shanmukhram/OrangeV2-2.0/media/Orange_Sesame_Walk.gif

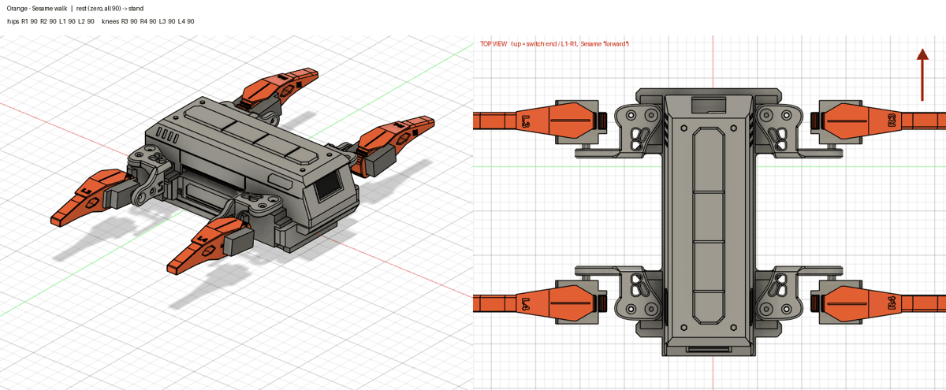
media/Orange_Sesame_Walk.gif
