shanmukhram/OrangeV2-2.0/media/Orange_Walk_Smooth_front.gif

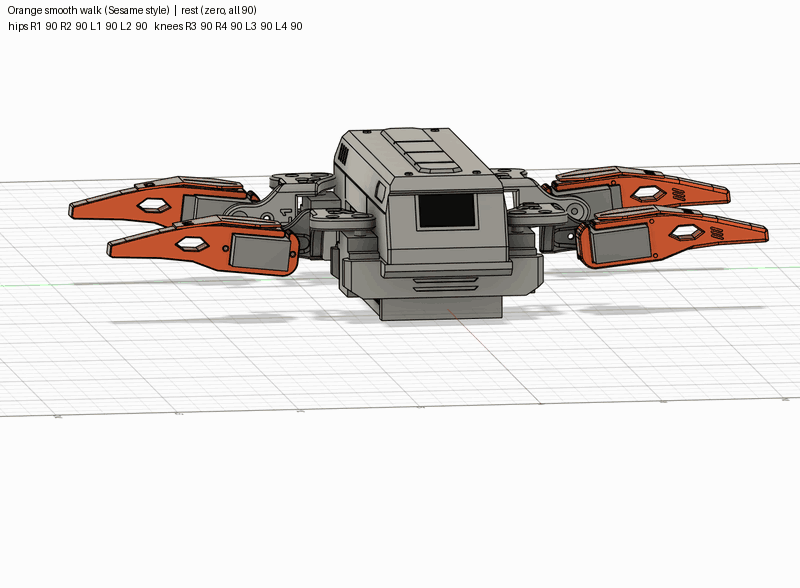
media/Orange_Walk_Smooth_front.gif
