shanmukhram/OrangeV2-2.0/media/skirt_design_options.png

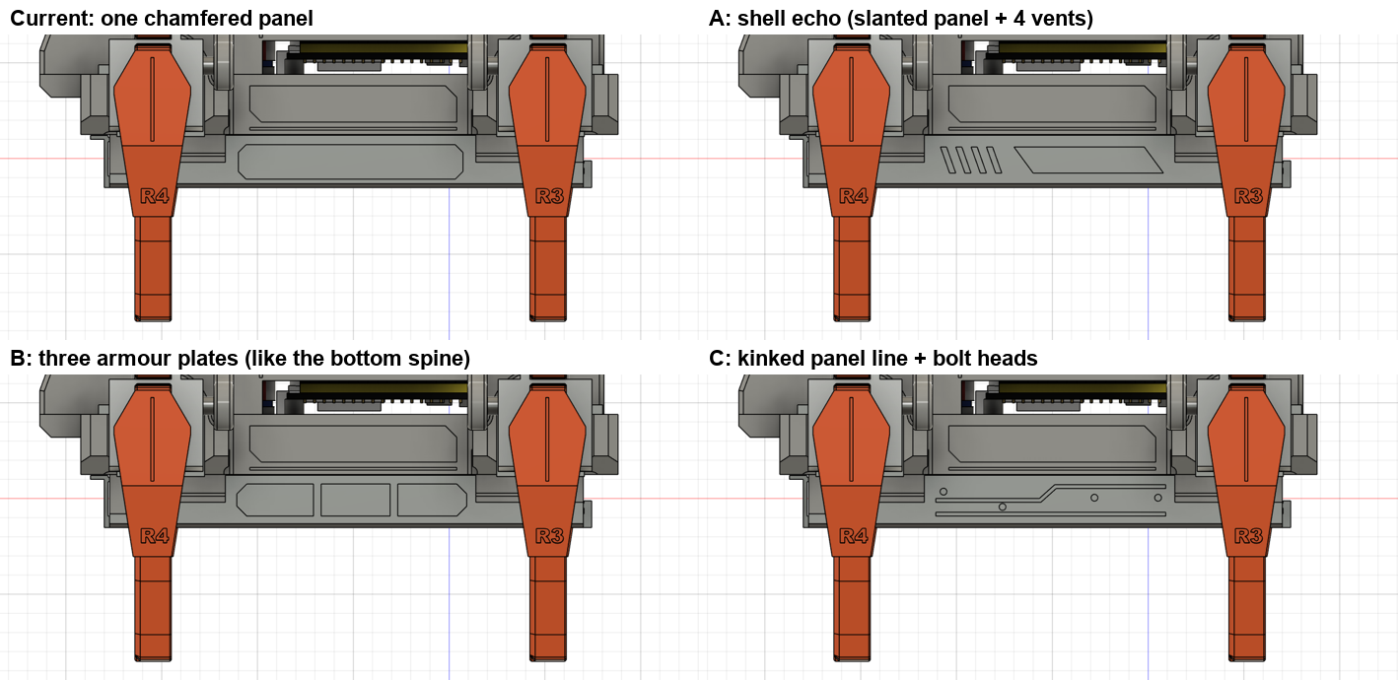
media/skirt_design_options.png
