shanmukhram/OrangeV2-2.0/fusion/assembly/Orange_Assembly_v2.step

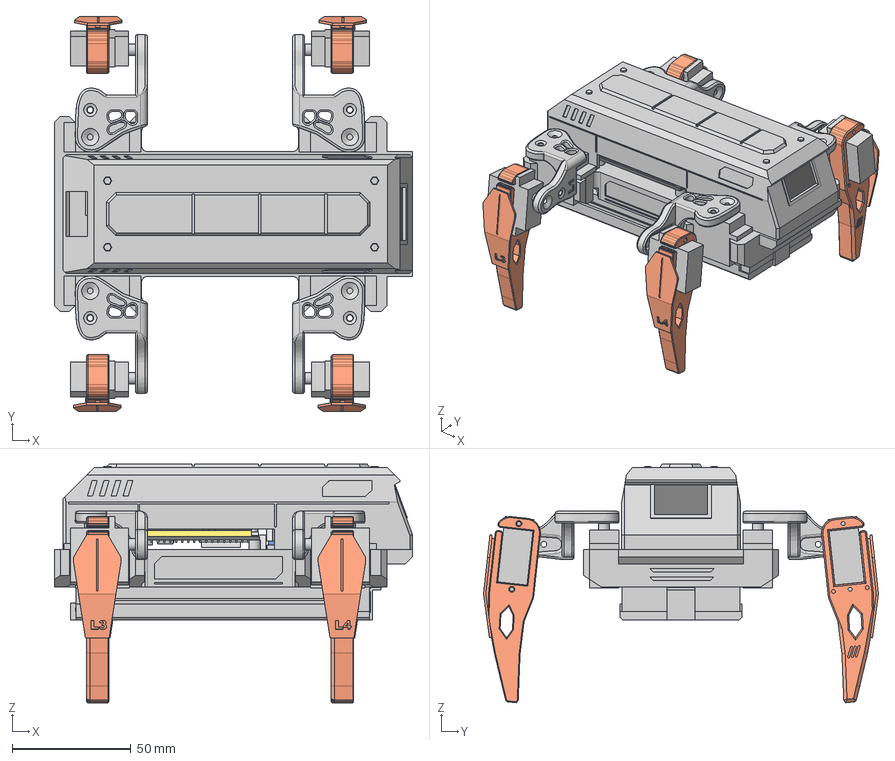
[picture p5: CAD file, 2026-11-07]
fusion/assembly/Orange_Assembly_v2.step
150.9 x 166.4 x 100.5 mm
