shanmukhram/OrangeV2-2.0/fusion/base_battery_holder/Orange_Base_BatteryHolder_v2.step

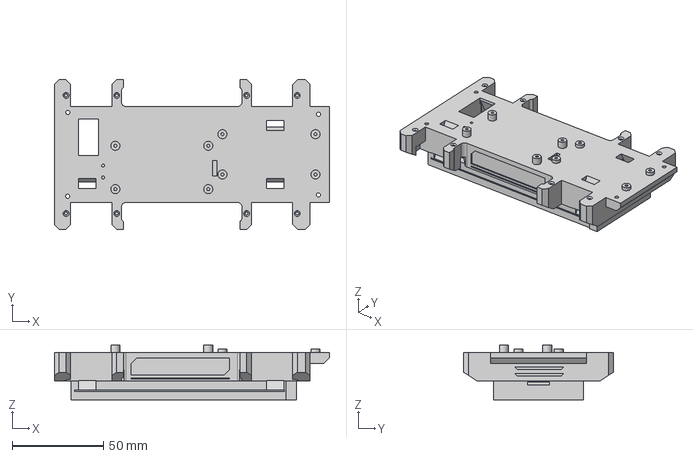
[picture p6: CAD file, 2026-11-07]
fusion/base_battery_holder/Orange_Base_BatteryHolder_v2.step
150.9 x 82.1 x 30.0 mm
