shanmukhram/OrangeV2-2.0/fusion/bottom_cover/skirt/Orange_BottomCover_Skirt_v2_with_cosmetics.step

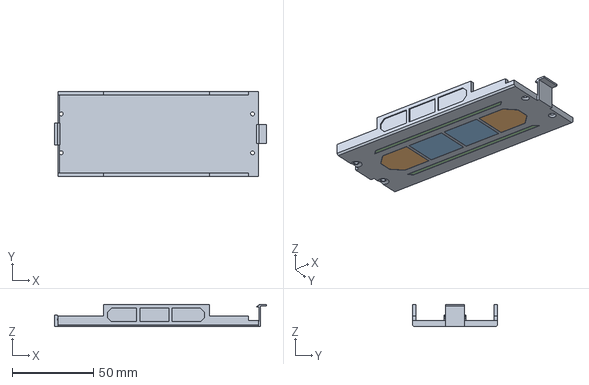
[picture p7: CAD file, 2026-11-07]
fusion/bottom_cover/skirt/Orange_BottomCover_Skirt_v2_with_cosmetics.step
130.8 x 52.6 x 13.7 mm
