shanmukhram/OrangeV2-2.0/fusion/bottom_cover/standard/Orange_BottomCover_v2_with_cosmetics.step

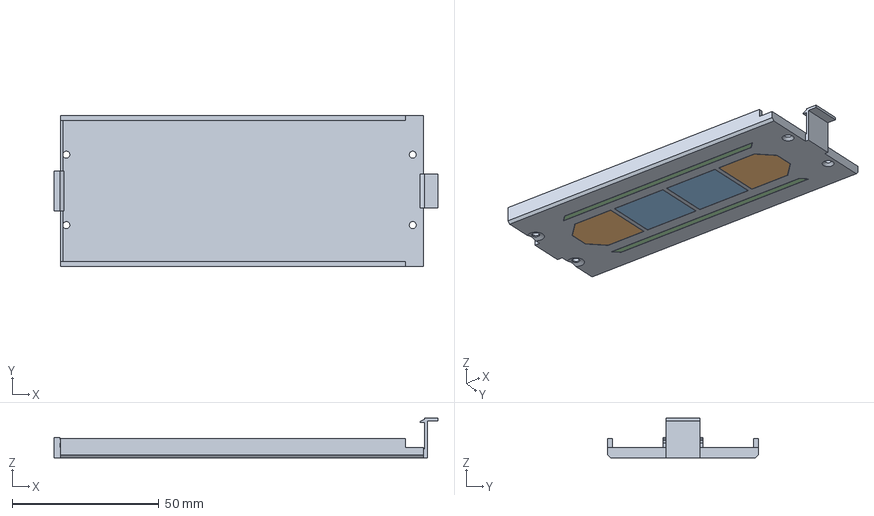
[picture p8: CAD file, 2026-11-07]
fusion/bottom_cover/standard/Orange_BottomCover_v2_with_cosmetics.step
130.8 x 51.4 x 13.6 mm
