shanmukhram/OrangeV2-2.0/fusion/lower_leg/Orange_LowerLeg_v2_R4.step

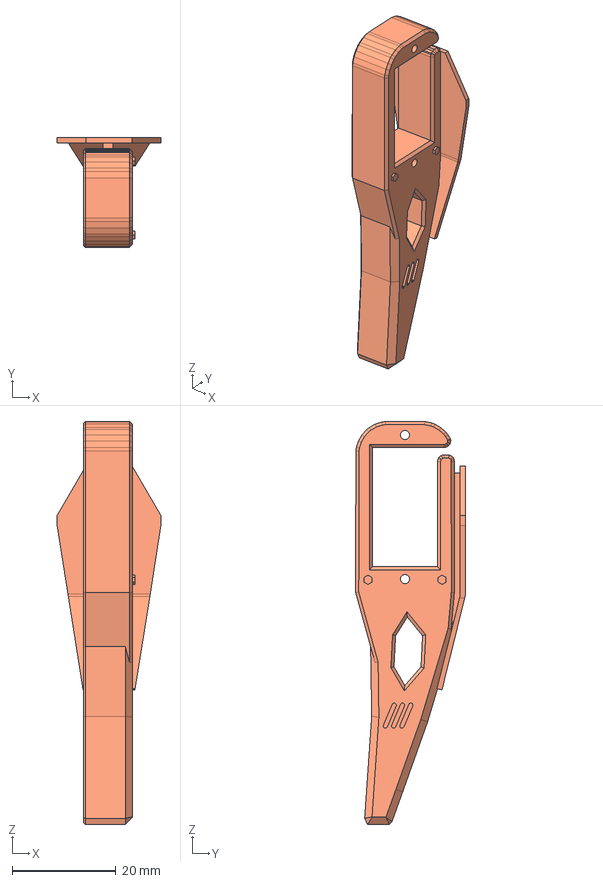
[picture p9: CAD file, 2026-11-07]
fusion/lower_leg/Orange_LowerLeg_v2_R4.step
20.0 x 21.2 x 77.7 mm
