shanmukhram/OrangeV2-2.0/fusion/perfboard_shelf/Orange_PerfboardShelf_v2.step

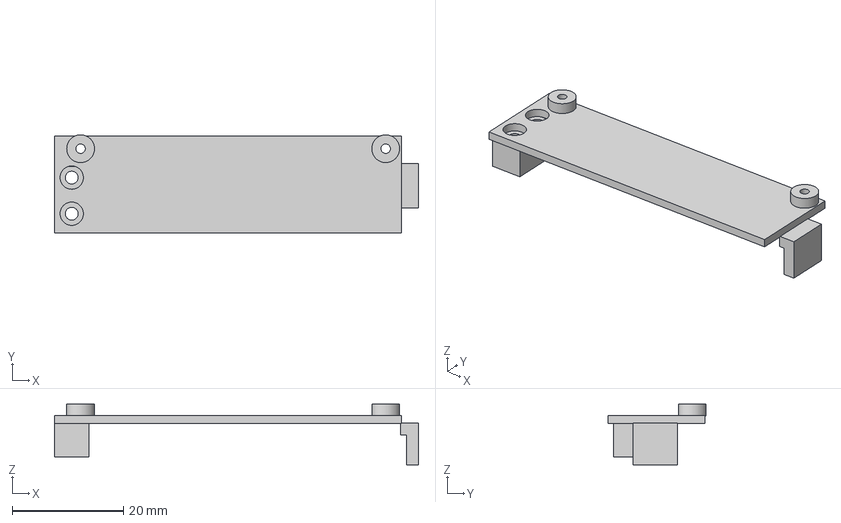
[picture p10: CAD file, 2026-11-07]
fusion/perfboard_shelf/Orange_PerfboardShelf_v2.step
65.5 x 17.7 x 10.9 mm
