shanmukhram/OrangeV2-2.0/fusion/top_shell/Orange_TopShell_v2.step

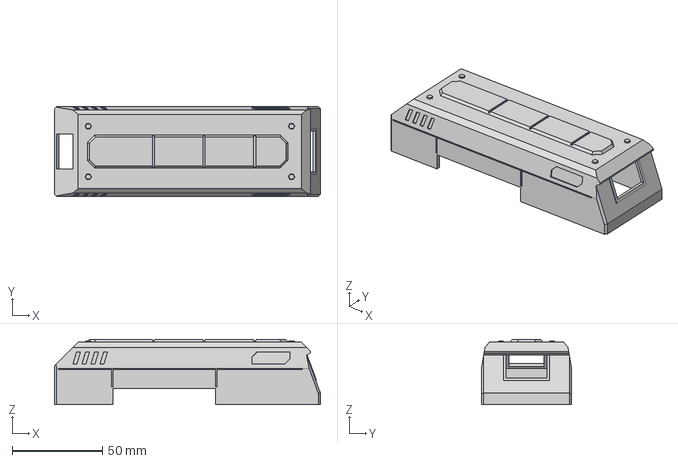
[picture p11: CAD file, 2026-11-07]
fusion/top_shell/Orange_TopShell_v2.step
147.2 x 49.9 x 36.0 mm
