shanmukhram/OrangeV2-2.0/fusion/upper_leg/bone_single_hole/Orange_UpperLeg_Bone_SingleHole_v2_R1.step

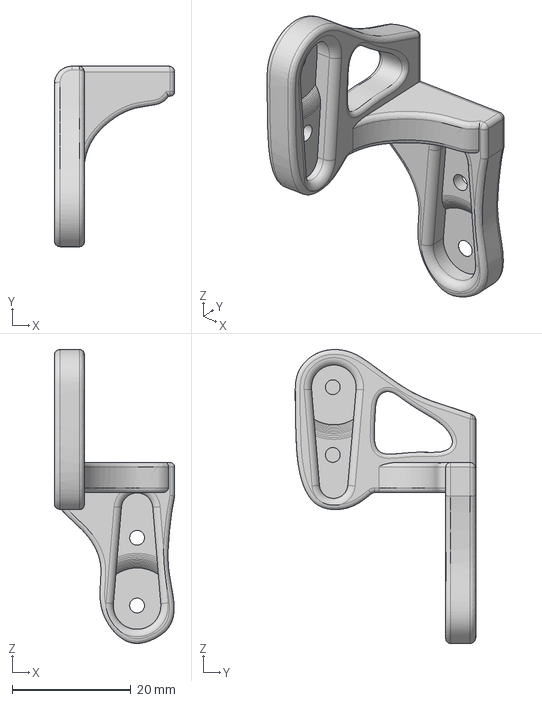
[picture p13: CAD file, 2026-11-07]
fusion/upper_leg/bone_single_hole/Orange_UpperLeg_Bone_SingleHole_v2_R1.step
20.3 x 30.5 x 49.6 mm
