shanmukhram/OrangeV2-2.0/fusion/upper_leg/tactical/Orange_UpperLeg_Tactical_v2_L1.step

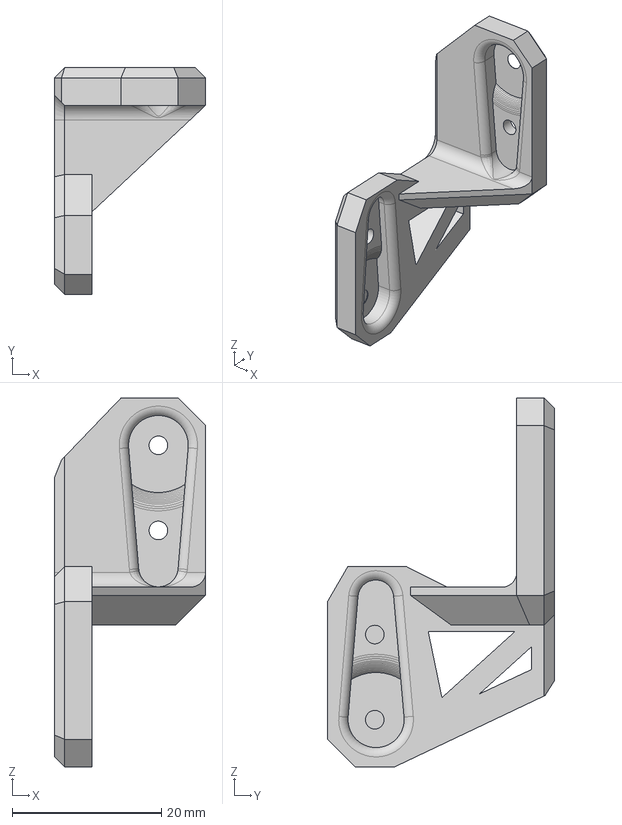
[picture p14: CAD file, 2026-11-07]
fusion/upper_leg/tactical/Orange_UpperLeg_Tactical_v2_L1.step
20.3 x 30.5 x 49.5 mm
