shanmukhram/OrangeV2-2.0/stl/bottom_cover/skirt/Orange_BottomCover_Skirt_v2_Cosmetic_StripeR.stl

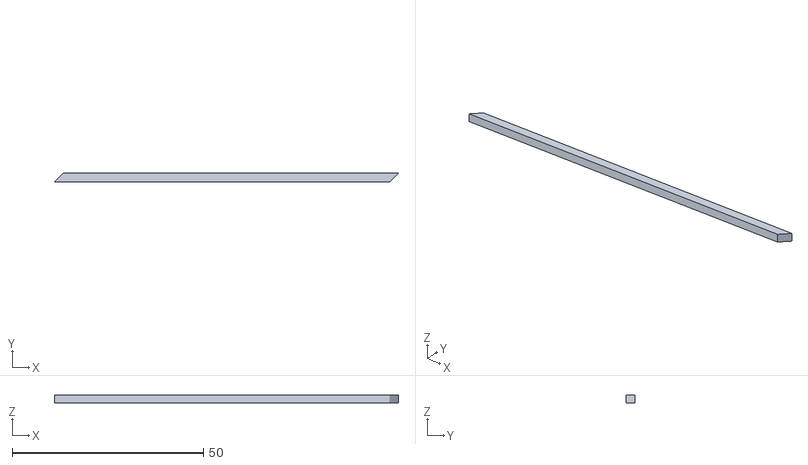
[picture p15: CAD file, 2026-11-07]
stl/bottom_cover/skirt/Orange_BottomCover_Skirt_v2_Cosmetic_StripeR.stl
89.9 x 2.30 x 2.00
