shanmukhram/OrangeV2-2.0/stl/bottom_cover/standard/Orange_BottomCover_v2.stl

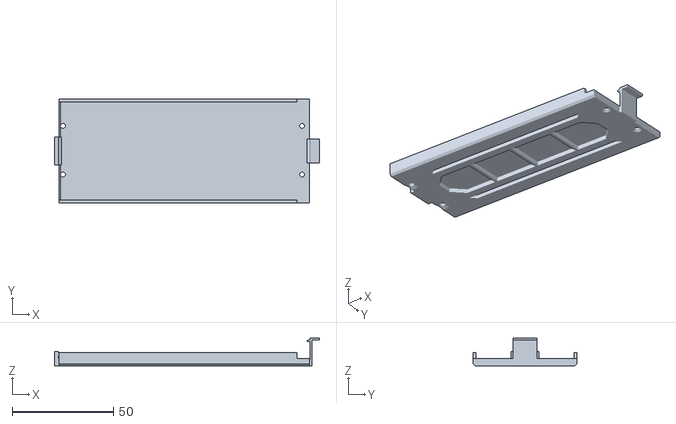
[picture p16: CAD file, 2026-11-07]
stl/bottom_cover/standard/Orange_BottomCover_v2.stl
130.8 x 51.4 x 13.6
