shanmukhram/OrangeV2-2.0/scripts/assembly/asm/MG90S_7.stl

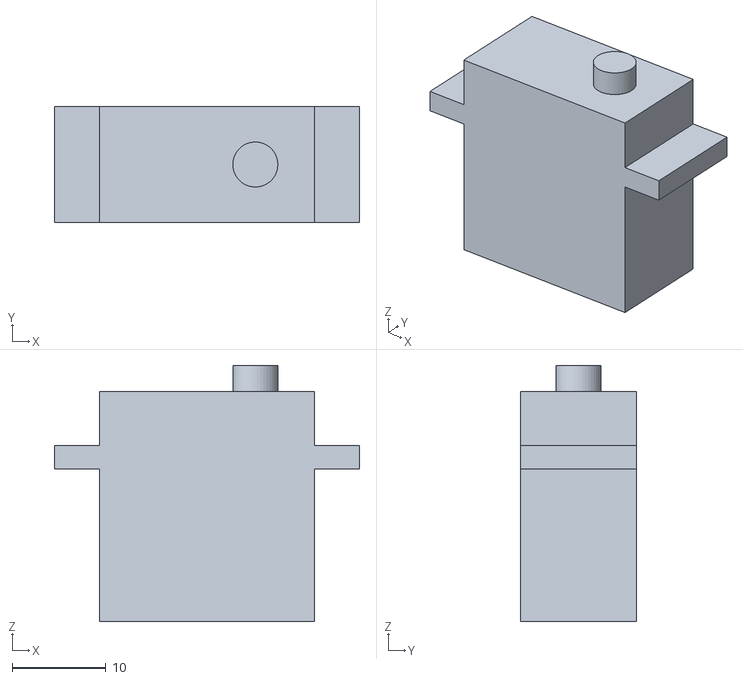
[picture p18: CAD file, 2026-11-07]
scripts/assembly/asm/MG90S_7.stl
32.5 x 12.4 x 27.3
