shanmukhram/OrangeV2-2.0/stl/bottom_cover/skirt/Orange_BottomCover_Skirt_v2_Cosmetic_Spine1.stl

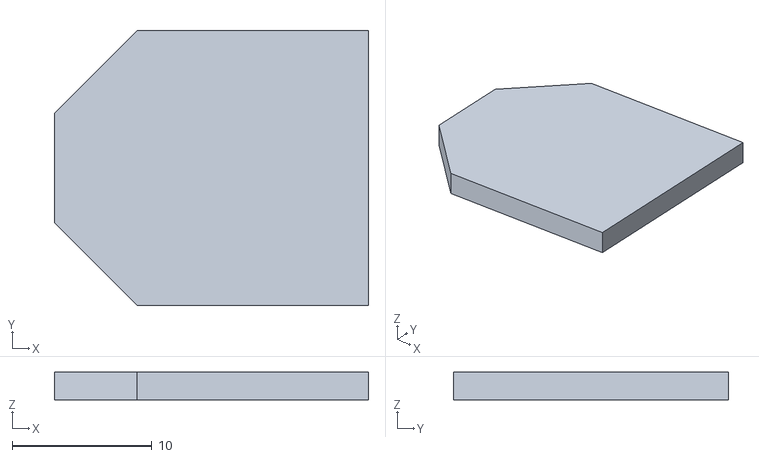
[picture p19: CAD file, 2026-11-07]
stl/bottom_cover/skirt/Orange_BottomCover_Skirt_v2_Cosmetic_Spine1.stl
22.5 x 19.7 x 2.00
