shanmukhram/OrangeV2-2.0/stl/bottom_cover/standard/Orange_BottomCover_v2_Cosmetic_Spine4.stl

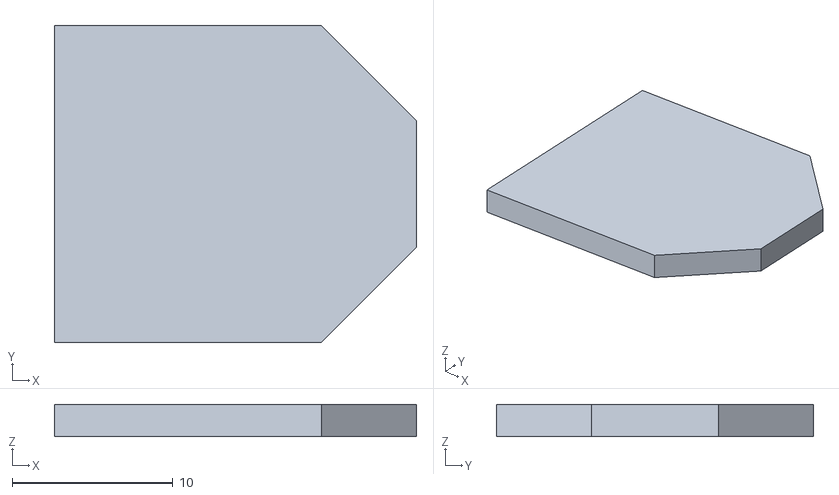
[picture p20: CAD file, 2026-11-07]
stl/bottom_cover/standard/Orange_BottomCover_v2_Cosmetic_Spine4.stl
22.5 x 19.7 x 2.00
