shanmukhram/OrangeV2-2.0/stl/bottom_cover/skirt/Orange_BottomCover_Skirt_v2_Cosmetic_Spine2.stl

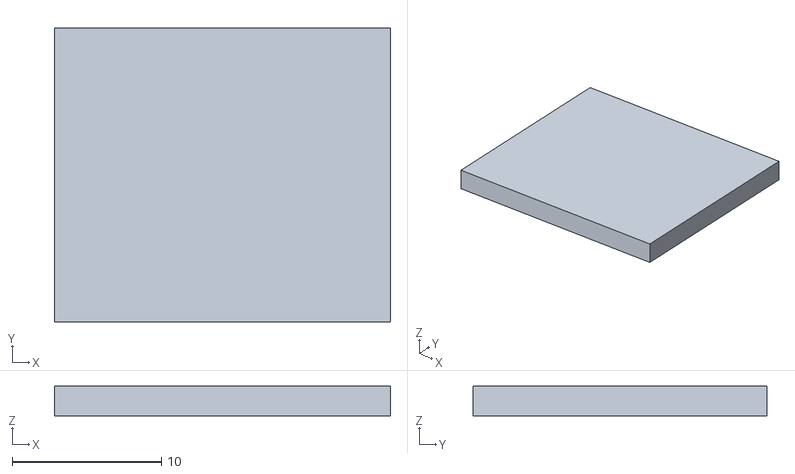
[picture p21: CAD file, 2026-11-07]
stl/bottom_cover/skirt/Orange_BottomCover_Skirt_v2_Cosmetic_Spine2.stl
22.5 x 19.7 x 2.00
