shanmukhram/OrangeV2-2.0/stl/bottom_cover/skirt/Orange_BottomCover_Skirt_v2.stl

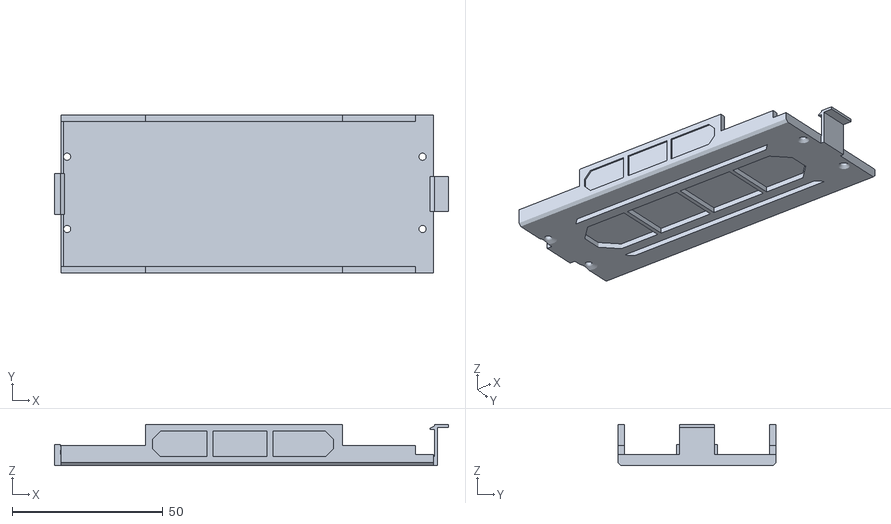
[picture p22: CAD file, 2026-11-07]
stl/bottom_cover/skirt/Orange_BottomCover_Skirt_v2.stl
130.8 x 52.6 x 13.7
