shanmukhram/OrangeV2-2.0/scripts/assembly/asm/body_Buck.stl

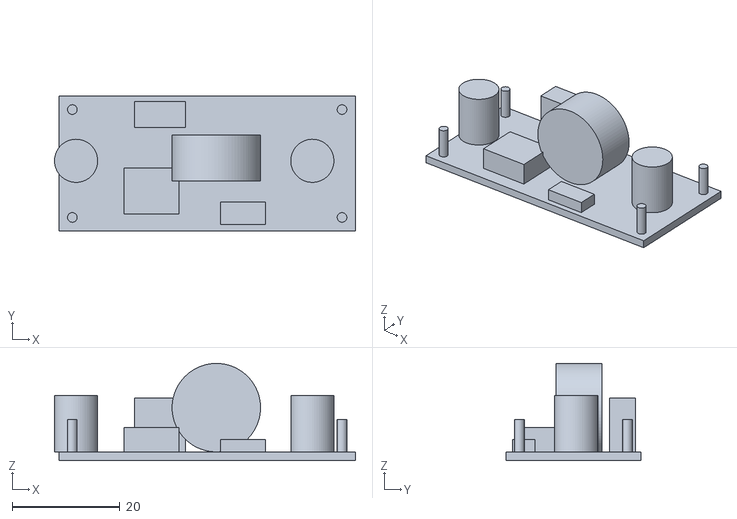
[picture p23: CAD file, 2026-11-07]
scripts/assembly/asm/body_Buck.stl
55.8 x 25.0 x 18.0
