shanmukhram/OrangeV2-2.0/scripts/assembly/asm/body_OLED.stl

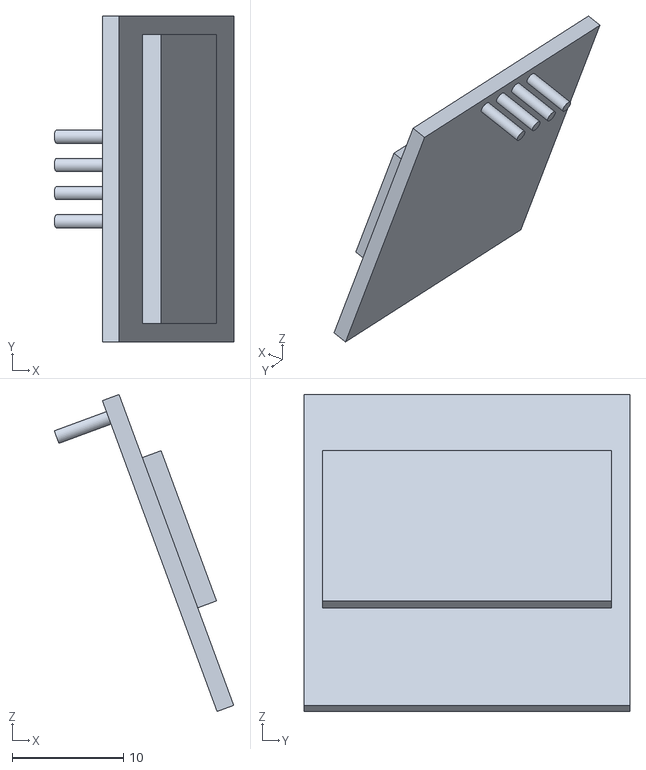
[picture p24: CAD file, 2026-11-07]
scripts/assembly/asm/body_OLED.stl
16.1 x 29.3 x 28.5
