shanmukhram/OrangeV2-2.0/scripts/assembly/asm/body_ESP32.stl

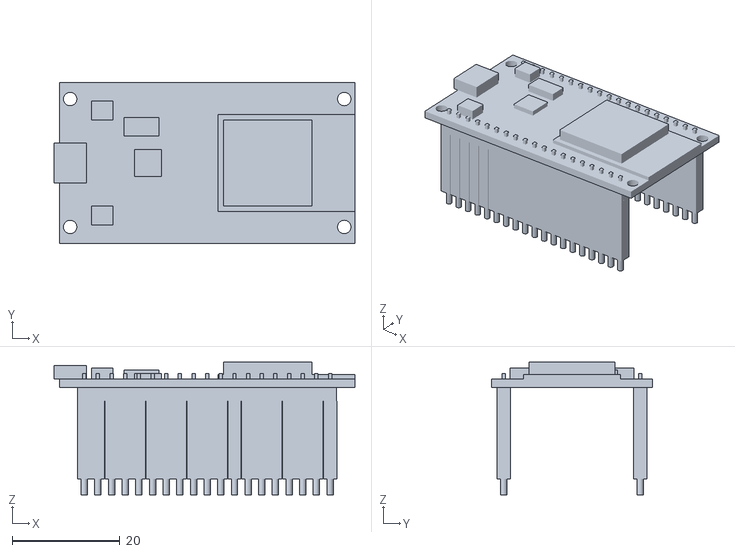
[picture p25: CAD file, 2026-11-07]
scripts/assembly/asm/body_ESP32.stl
56.0 x 30.0 x 24.7
