shanmukhram/OrangeV2-2.0/(list of files, cad)

Other CAD files:
fusion/upper_leg/bone_two_holes/Orange_UpperLeg_Bone_TwoHoles_v2_R2.step
scripts/assembly/asm/LowerLeg_L3_1.stl
scripts/assembly/base_wide.step
scripts/upper_leg/checks/LL2_aligned.stl
stl/base_battery_holder/Orange_Base_BatteryHolder_v2.stl
stl/lower_leg/Orange_LowerLeg_v2_R4.stl
stl/perfboard_shelf/Orange_PerfboardShelf_v2.stl
stl/top_shell/Orange_TopShell_v2.stl
stl/upper_leg/bone_multi_hole/Orange_UpperLeg_Bone_MultiHole_v2_R1.stl
stl/upper_leg/bone_single_hole/Orange_UpperLeg_Bone_SingleHole_v2_R2.stl
stl/upper_leg/bone_two_holes/Orange_UpperLeg_Bone_TwoHoles_v2_L1.stl
stl/upper_leg/tactical/Orange_UpperLeg_Tactical_v2_R1.stl
fusion/lower_leg/Orange_LowerLeg_v2_R3.step
fusion/upper_leg/bone_multi_hole/Orange_UpperLeg_Bone_MultiHole_v2_L1.step
fusion/upper_leg/bone_single_hole/Orange_UpperLeg_Bone_SingleHole_v2_L1.step
fusion/upper_leg/bone_two_holes/Orange_UpperLeg_Bone_TwoHoles_v2_L1.step
scripts/assembly/asm/UpperLeg_R2_1.stl
stl/bottom_cover/skirt/Orange_BottomCover_Skirt_v2_Cosmetic_StripeL.stl
stl/bottom_cover/standard/Orange_BottomCover_v2_Cosmetic_StripeL.stl
stl/lower_leg/Orange_LowerLeg_v2_L4.stl
stl/upper_leg/bone_multi_hole/Orange_UpperLeg_Bone_MultiHole_v2_L1.stl
stl/upper_leg/bone_single_hole/Orange_UpperLeg_Bone_SingleHole_v2_L2.stl
stl/upper_leg/bone_two_holes/Orange_UpperLeg_Bone_TwoHoles_v2_L2.stl
stl/upper_leg/tactical/Orange_UpperLeg_Tactical_v2_L2.stl
fusion/lower_leg/Orange_LowerLeg_v2.step
fusion/upper_leg/bone_multi_hole/Orange_UpperLeg_Bone_MultiHole_v2_L2.step
fusion/upper_leg/bone_single_hole/Orange_UpperLeg_Bone_SingleHole_v2_R2.step
fusion/upper_leg/bone_two_holes/Orange_UpperLeg_Bone_TwoHoles_v2_L2.step
fusion/upper_leg/tactical/Orange_UpperLeg_Tactical_v2_L2.step
stl/lower_leg/Orange_LowerLeg_v2_L3.stl
stl/upper_leg/bone_multi_hole/Orange_UpperLeg_Bone_MultiHole_v2_L2.stl
stl/upper_leg/bone_single_hole/Orange_UpperLeg_Bone_SingleHole_v2_L1.stl
stl/upper_leg/bone_two_holes/Orange_UpperLeg_Bone_TwoHoles_v2_R1.stl
stl/upper_leg/tactical/Orange_UpperLeg_Tactical_v2_L1.stl
fusion/lower_leg/Orange_LowerLeg_v2_L3.step
fusion/upper_leg/bone_multi_hole/Orange_UpperLeg_Bone_MultiHole_v2_R2.step
fusion/upper_leg/bone_single_hole/Orange_UpperLeg_Bone_SingleHole_v2_L2.step
fusion/upper_leg/bone_two_holes/Orange_UpperLeg_Bone_TwoHoles_v2_R1.step
fusion/upper_leg/tactical/Orange_UpperLeg_Tactical_v2_R1.step
stl/lower_leg/Orange_LowerLeg_v2_R3.stl
stl/upper_leg/bone_multi_hole/Orange_UpperLeg_Bone_MultiHole_v2_R2.stl
stl/upper_leg/bone_single_hole/Orange_UpperLeg_Bone_SingleHole_v2_R1.stl
stl/upper_leg/bone_two_holes/Orange_UpperLeg_Bone_TwoHoles_v2_R2.stl
stl/upper_leg/tactical/Orange_UpperLeg_Tactical_v2_R2.stl
fusion/lower_leg/Orange_LowerLeg_v2_L4.step
scripts/assembly/asm/body_Perfboard.stl
stl/lower_leg/Orange_LowerLeg_v2.stl
scripts/assembly/asm/UpperLeg_L1_1.stl
stl/bottom_cover/skirt/Orange_BottomCover_Skirt_v2_Cosmetic_Spine3.stl
stl/bottom_cover/standard/Orange_BottomCover_v2_Cosmetic_Spine3.stl
scripts/assembly/asm/Base_wide_1.stl
scripts/assembly/asm/LowerLeg_R3_1.stl
scripts/assembly/asm/LowerLeg_L4_1.stl
scripts/assembly/asm/UpperLeg_L2_1.stl
scripts/assembly/asm/body_Top.stl
scripts/assembly/asm/UpperLeg_R1_1.stl
scripts/assembly/asm/LowerLeg_R4_1.stl
fusion/_superseded/Orange_Assembly_v2_blind-holes.step
fusion/_superseded/Orange_Assembly_v2_no-bottom-cover.step
fusion/_superseded/Orange_Assembly_v2_no-legs_original-width.step
fusion/_superseded/Orange_Base_BatteryHolder_v2_no-cover-latch.step
fusion/_superseded/Orange_Base_BatteryHolder_v2_original-width.step
fusion/_superseded/Orange_LowerLeg_v2_L3_blind-holes.step
fusion/_superseded/Orange_LowerLeg_v2_L4_blind-holes.step
fusion/_superseded/Orange_LowerLeg_v2_R3_blind-holes.step
fusion/_superseded/Orange_LowerLeg_v2_R4_blind-holes.step
fusion/_superseded/Orange_LowerLeg_v2_blind-holes.step
fusion/assembly/Orange_Assembly_v2.f3d
fusion/assembly/Orange_Assembly_v2_WithLegs.f3d
fusion/base_battery_holder/Orange_Base_BatteryHolder_v2.f3d
fusion/bottom_cover/skirt/Orange_BottomCover_Skirt_v2.f3d
fusion/bottom_cover/standard/Orange_BottomCover_v2.f3d
fusion/lower_leg/Orange_LowerLeg_v2.f3d
fusion/perfboard_shelf/Orange_PerfboardShelf_v2.f3d
fusion/top_shell/Orange_TopShell_v2.f3d
fusion/upper_leg/bone_multi_hole/Orange_UpperLeg_Bone_MultiHole_v2.f3d
fusion/upper_leg/bone_single_hole/Orange_UpperLeg_Bone_SingleHole_v2.f3d
fusion/upper_leg/bone_two_holes/Orange_UpperLeg_Bone_TwoHoles_v2.f3d
fusion/upper_leg/tactical/Orange_UpperLeg_Tactical_v2.f3d
stl/_superseded/Orange_Base_BatteryHolder_v2_no-cover-latch.stl
stl/_superseded/Orange_Base_BatteryHolder_v2_original-width.stl
stl/_superseded/Orange_LowerLeg_v2_L3_blind-holes.stl
stl/_superseded/Orange_LowerLeg_v2_L4_blind-holes.stl
stl/_superseded/Orange_LowerLeg_v2_R3_blind-holes.stl
stl/_superseded/Orange_LowerLeg_v2_R4_blind-holes.stl
stl/_superseded/Orange_LowerLeg_v2_blind-holes.stl
